Niteshmkd/Origamibot/Project Report_Grumpy Gardeners.pdf

XXX-X-XXXX-XXXX-X/XX/$XX.00 ©20XX IEEE

# HelioPhilaBot: A Bio-Inspired Origami Robot that Mimics a Sunflower

Nitesh Kumar
Dept. of Mechanical Engineering Texas A&M University
College Station, USA
niteshk@tamu.edu

Om Sukhadia
Dept. of Mechanical Engineering Texas A&M University
College Station, USA
om_smc23@tamu.edu

Pramod Allam
Dept. of Engineering Technology Texas A&M University
College Station, USA
pramod.na@tamu.edu

Soumya Mohanty
Dept. of Mechanical Engineering Texas A&M University
College Station, USA
mohantysoumya@tamu.edu

Abstract— This paper presents HelioPhilaBot, which is a robotic creation aimed at emulating the sunflower's movement and heliotropic behavior. The challenge lay in devising a stem structure that could flexibly mimic the sunflower's lateral movements while maintaining stability and rigidity. To achieve this, an origami-inspired design, termed the "twisted tower," was identified as a suitable actuator capable of executing twisting and bending motions. Actuation was facilitated using threads controlled by two geared DC motors. The robot was able to detect the presence of a light source with the help of light sensors and successfully demonstrated twisting and the bending motion while following the movement of the light source. The structure of the robot, its actuation and circuit integration have been discussed in the paper. Forward kinematics and control scheme for the robot were also explored and the analyses for the same have been laid out in detail.

Keywords—bio-inspired robotics, origami actuators, soft actuator

I. INTRODUCTION
Nature is a rich source of inspiration in the field of robotics. The motion patterns, movement mechanisms and behaviour of natural organisms to different stimuli have inspired scientists to draw parallelism and employ similar methodologies to solve problems in the real world. One such organism of fascination in the nature is the sunflower. Sunflowers are tall and have stems that are flexible and allow them certain degrees of freedom for movement. More interestingly, they exhibit heliotropic behaviour, that is, they track the sun’s movement across the sky through the duration of the day.

Origami describes a method of paper-folding that creates three dimensional structures from two dimensional paper sheets [1], [2], [3]. The implementation of origami structures in robotics has been on a constant rise because of their unique properties that blend flexibility with rigidity allowing smooth movement and space reduction. Origami designs have been used as actuators [5], [6], springs [7], and printable robotics [4].

The aim of this research project was to create a robot that emulates the movement of a sunflower as well as its heliotropic behaviour. In this paper, we present our sunflower mimicking origami robot, called the HelioPhilaBot. The stem structure of the sunflower robot had to be an actuator that would be flexible enough to mimic the sideways movement in a sunflower while holding its position by the virtue of its own stiffness and rigidity. An origami inspired design called the “twisted tower” was found suitable for the purpose and implemented as the actuator. The actuator is capable of performing 2 types of movements: twisting motion and bending motion. The actuation has been done carried out using threads. The design of the actuator, forward kinematics and the control scheme of the robot have been discussed in detail.

II. DESIGN OF THE ROBOT

A. Twisted tower
Many origami structures were analysed for the making the actuator. Finally, an origami design called the “twisted tower” by Mihiko Tachibana was selected [9].

The twisted tower is a modular origami design and is constructed layer wise. All the layers are identical and are octagonal in shape. These layers are stacked one on top of another to form the tower structure. There are two types of origami pieces that are required to make the twisted tower: Type 1 and Type 2 (Fig. 1 (a)). The base layer requires 24 origami pieces, while the top layer 16 origami pieces. All the layers in between require 16 origami pieces each. So, for a n layer twisted tower,

No. of origami pieces required= 8(2n + 1)

The twisted tower in the paper has 7 layers. In total, 120 pieces of origami were folded and assembled (Fig. 1 (b)). Each piece was made of a rectangular piece of construction paper of dimension 10 x 5 cm²
. Construction paper was used instead of normal origami paper because of its higher stiffness. The diameter of the circle circumscribing the octagonal pattern is 7.5 cm. Height of each layer is 3 cm. Total height of the tower is 21 cm.

Decorative pieces of sunflower origami were folded to be attached to the top layer of the twisted tower as shown in Fig. 1 (c).

(a) | (b) | (c)

Fig. 1. Twisted Tower a) origami piece b) assembled 7-layer tower c) sunflower origami

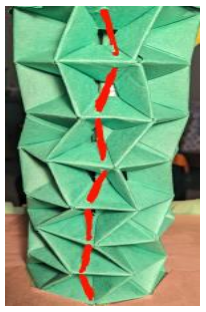
[picture p1: figure]
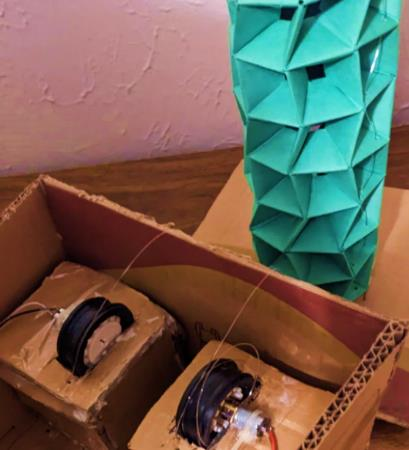
[picture p2: figure]

(a) (b)

Fig. 2. Actuation with threads a) setup showing how the threads are coonected to the motors b) routing of the thread

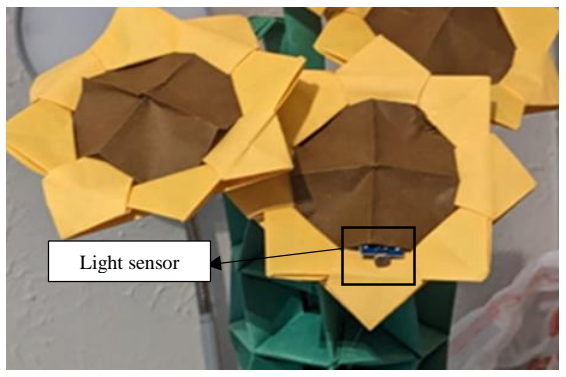
[picture p3: figure]
Light sensor

Fig. 3. Light sensor on the sunflower origami

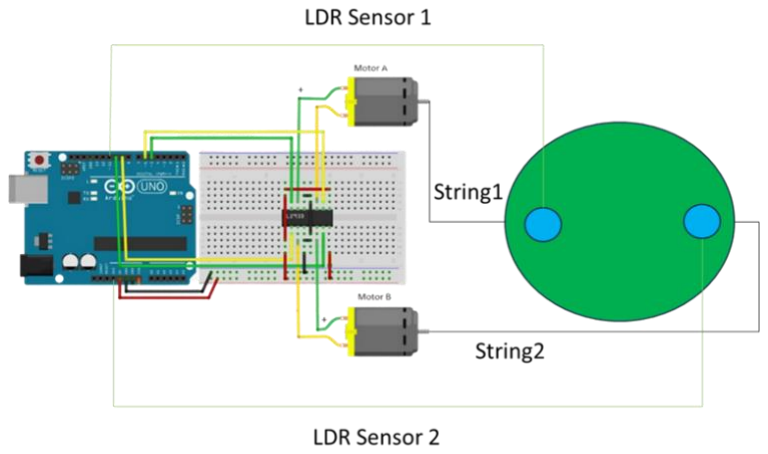
[picture p4: figure]

Fig. 4. Circuit diagram

B. Actuation and Circuit Integration
The twisted tower is actuated with the help of threads routed on either side of the twisted tower and controlled by two geared DC motors as shown in Fig. 2 (a). Fig. 2 (b) shows the routing of the thread on one side of the tower .Two light sensors are placed on 2 different sunflower origamis. Fig. 3 shows the placement of the light sensor on one of the sunflower origamis.

The aim is to keep the light source between the two sensors mounted on the sunflower origamis. Arduino code and circuit are integrated to achieve this desired goal. The circuit diagram is shown in Fig. 4.

Whenever the light source moves to the left side of the sunflower head, the left sensor detects the sunlight, and the left motor wraps the thread to bend the twisted tower until the light comes in the centre of two sensors. When light moves back towards the right, the left motor runs until the origami structure come back to the initial upright position. After this right motor actuates and bends the structure in the opposite direction. If no light is detected, both the motors actuate and contract the twisted tower back to its original position.

III. MATHEMATICAL ANALYSIS

A. Forward Kinematics
The possible motions in the twisted tower are twisting about its vertical axis and bending towards one of the edgees of the octagon. Since the structure has rigid body like motions, it is assumed that the traditional rigid body dynamics hold for this particular case.
1. Twisting Motion

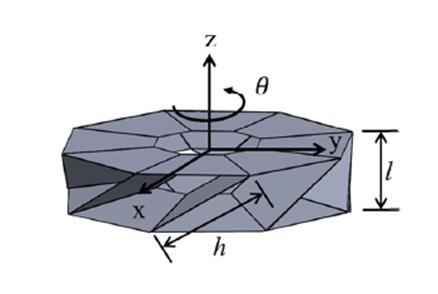
[picture p5: figure]

Fig. 5. Construct of a single-layered origami tower aligned with a body-fixed frame, involving dimensions such as h (the link's length), θ (the z-axis rotation), and l (the vertical displacement between two plates) [8]

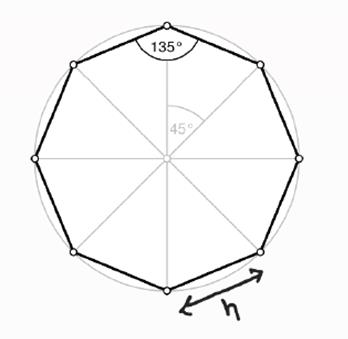
[picture p6: figure]

Fig. 6. Top view of the twisted tower

The twisting motion of the twisted tower can be represented by Fig. 5 and the top view of the twisted tower is shown in Fig. 6. Let r be the radius of the circle about which the edge is rotating. Assuming that the perimeter of the circumscribing circle is almost equal to the perimeter of the octagon, it can be said that r ≈

4ℎ
π

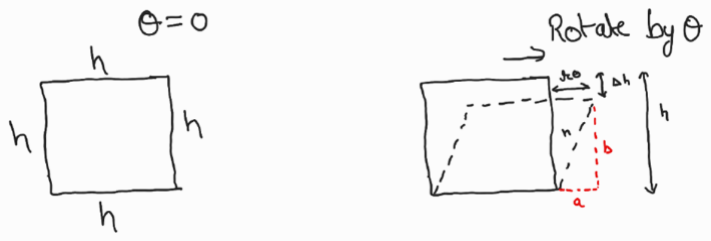
[picture p7: figure]

Fig. 7. Side view of a single element in a layer and its transformation when there is a small twist of θ

Clearly,
a

2 + b

2 = ℎ

2
a = rθ and b = ℎ − Δℎ

⇒ r

2θ

2 + ℎ

2

(1 −

Δℎ
ℎ

)

2
= ℎ

2

For low range of motion, Δℎ
ℎ

≈ 0

r

2θ

2 + ℎ

2

(1 −

2Δℎ
ℎ

) = ℎ
2

⇒ Δℎ =

8ℎθ

2
π

2

The rigid-body transformation by twisting the top plate by θ radian is given by
T = [
e

ŵθ

(ℎ −

8ℎθ

2
π²

) w⃗

0⃗ T | 1

],

where w⃗ = [0,0,1]

T
ŵ = skew symmetric matrix corresponding to w⃗

If we have N such layers, then the transformation matrix is given by

T0

N = [
e

ŵθ1…..,N (Nℎ −
8ℎθ

2
π

2 ∑θi
2

N

i=1

) ŵ

0⃗ T | 1

]

where θ1 | , N = ∑ θi

N
i=1

In the twisting motion, alternate layers twist in opposite direction but with the same angle.

θi = −θi+1

θ1 | , N = ∑θi

N

i=1

= 0

As a result, the rotation matrix becomes identity and only a vertical displacement is observed.
Δℎ =

8ℎ
π

2

Nθ

2

2. Bending Motion

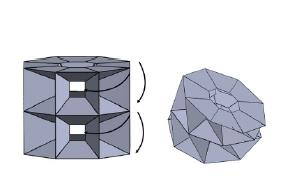
[picture p8: figure]

Fig. 8. Bending motion of the twisted tower [8]

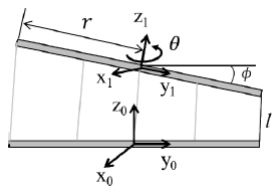
[picture p9: figure]

Fig. 9. Geometry of a single layer twister tower while bending [8]

Hoff et al [8] gave the transformation matrix for the bending motion of a single layer of the twisted tower.
T = [
cθ | −sθ | 0 | 0
cφsθ −sφsθ
0 | cφcθ −sφcθ
| 0 | −sφ cφ
| | 0 | r −(r + l)sφ lcφ + rsφ
| | | 1

]

where r is the radius of the circumscribed circle of the octagon layer, l is the displacement between two plates measured along the z0

-axis, φ is the bending angle, and θ is the twisting angle resulted by bending.

Using that θ = 0 when φ = 0 and |θ| ≈ θmax when φ = φmax , the relationship between θ and φ can be approximated by

θ ≈

θmax

φmax

φ

where φmax is the maximum bending angle that a single layer of twisted tower can generate and θmax is the resulting torsional angle.
For a total bending of φ, θ can be split into N equal parts for each layer.
θ ≈

1
N

θmax

φmax

φ

B. Control Scheme
The controller used for this project was an on/off controller. However, we can achieve a better control if we use a PID control. In this section we present a PID scheme which can used to improve the control of this system. In order to have a better control we assumed that dc motor can be controlled using a current controller and we have a sensor to detect the angle of impact of sunlight.

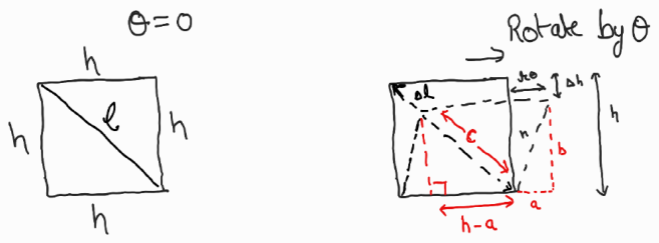
[picture p10: figure]

Fig. 10. Side view of the geometry of a single layer twister tower while bending showing change in l

Clearly,
b

2 + (ℎ − a)

2 = c

2

(ℎ −Δℎ)

2 + (ℎ −rθ)

2 = (l − Δl)

2

θ ≈ 0,

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
(1 −

Δℎ
ℎ

)

2
+ ℎ

2

(1 −

rθ
ℎ

)

2
= l

2

(1 −

Δl
l

)

2

ℎ

2

(1 −

2Δℎ
ℎ

)+ ℎ
2

(1 −

2rθ
ℎ

) = l
2

(1 −

2Δl
l

)

2ℎ² − 2Δℎℎ − 2rθℎ = l

2 − 2Δll

Using Pythagoras theorem,

ℎ

2 + ℎ

2 = l

2

, l = √2ℎ

Δℎℎ + rθℎ = Δll

Using, Δℎ =

8ℎθ

2
π²

, r =

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
θℎ = Δl√2ℎ

Δl =

8ℎθ

2
√2π
2

+

4ℎθ
√2π
θ ≈ 0, θ ≫ θ

2

Δl ≈

2√2ℎθ
π
Now, Δl here represents that if we pull the thread by Δl we will observe θ twist in the origami layer.

In same fashion, we can write the total Δl for N such layers with equal twist θ.

Δl ≈

2√2ℎNθ
π
Both desired Δℎ and φ are function of θ as we discussed in the previous section. If we can control θ we can control Δℎ and φ and θ can be controlled using Δl which represents the thread pulled by the motor.

Now if we use a current controlled DC motor, its angular acceleration can written as follows:
Hα = KI

I
where KI

is torque constant, I is the current and H is the moment of inertia of the pulley and motor shaft and R is the radius of the pulley attached to the motor

αR = Δl

̈

αR = Δl

̈=

KIRI
H

= KI

′
I

K′I

I =

2√2ℎNθ̈
π
Icommand = Kpe + Kdė+ Ki ∫ e dt

e = θd − θ

Our desired output is Δhd or φd

For the desired Δℎd, we can find a desired Δθd.

θd = √
π²

8Nℎ

Δℎd or θd =

1
N

θmax

φmax

φd

Error Dynamics:
Δl ̈= | 2√2Nℎθ̈
| π
e = θd − θ

Δl

̈= −

2√2Nℎë
π

= KI (Kpe + Kdė+Ki ∫ e dt)

ë+

KdKIπ
2√2ℎN

ė+

KpKIπ
2√2ℎN

e +

KiKIπ
2√2ℎN

∫ e dt = 0

Error Dynamics:

s

3 +

KdKIπ
2√2ℎN

s

2 +

KpKIπ
2√2ℎN

s +

KiKIπ
2√2ℎN

= 0

Following conditions must be satisfied for stability: KdKIπ
2√2ℎN

> 0, ⇒ Kd > 0

KpKIπ
2√2ℎN

> 0, ⇒ Kp > 0

KpKdKI
2√2ℎN

> Ki > 0

IV. DISCUSSION AND FUTURE WORK
In this paper, an origami robot that mimics a sunflower named HelioPhilaBot was presented. The structural design of the robot, robot actuation and circuit integration were thoroughly discussed. The two types of motion seen in the robot: twisting motion and bending motion were analysed and their rigid body kinematics were derived and studied. The control scheme of the robot was also discussed in detail.

The PID controller can be implemented if we can find the angle of impact of rays and use a motor with current controller. Frictional and inertial losses of DC motor and actuator could also be incorporated into the controller in the future.

Origami designs are being increasingly implemented in the field of soft robotics. This is because of their adaptive designs that can mimic natural motion. With the right material and design selection, innovative solutions can be developed to implement complicated motion patterns.

Furthermore, origami robots are a unique blend of art and science. Making origami robots can be a fun activity for children and inroduce them to the field of robotics.

ACKNOWLEDGMENT
This work was supported by Dr. Kiju Lee, Associate Professor, Department of Mechanical Engineering and course instructor for MEEN 612: Mechanics of Robotics Manipulators. Without her valuable guidance and financial support, this project would not have been possible.

REFERENCES

[1] T. Tachi, “3D Origami Design based on Tucking Molecule,” in Proc.4th International Conference on Origami in Science, Mathematics, and Education, 2006.
[2] E. Hawkes at al., “Programmable Matter by Folding,, PNAS, Vol. 107(28), pp. 12441-12445, 2010.
[3] P. Jackson, “Folding Techniques for Designers: From Sheet to Form,” Pap/Cdr. Laurence King Publishers, 2011.
[4] C. D. Onal, R. J. Wood, and D. Rus, “Towards Printable Robotics: Origami-Inspired Planar Fabrication of Three-Dimensional Mechanisms, IEEE ICRA, pp. 4608-4613, 2011.
[5] H. Okuzaki at al., “A Biomorphic Origami Actuator Fabricated by Folding a Conducting Paper, 4th World Congress on Biomimetics, Artificial Muscles and Nano-Bio, 127, 2008.
[6] R. V. Martinez at al., “Elastomeric Origami: Programmable Paper-Elastomer Composites as Pneumatic Actuators, Advanced Functional Materials, Vol. 22, Iss. 7, pp. 1376-1384, 2012.
[7] C. C. Min and H. Suzuki, “Geometrical Properties of Paper Spring, 41th CIRP Conference on Manufacturing Systems, pp. 159-162, 2008.
[8] E. VanderHoff, D. Jeong, and K. Lee, "Origamibot-I: A Thread-Actuated
Origami | Robot | for | Manipulation | and | Locomotion", (http://case.edu/mae/robotics/pdf/LeeIROS2014.pdf) IEEE/RSJ
International Conference on Intelligent Robots and Systems (IROS) 2014.
[9] http://origamimaniacs.blogspot.com/2012/02/twisted-tower-bymihoko-tachibana.html.
